idiot250/pixelixx/BOM.csv

Item | Qty | Supplier | Cost/item | Total Cost | link
PCB | 1 | jlcpcb | $4.00 | $4.00 | https://jlcpcb.com
WS2812B | 1 | aliexpress | $9.85 | $9.85 | https://www.aliexpress.com/item/2251832190824742.html?mp=1
Estimated total shipping | 1 |  |  | $3.30
