idiot250/pixelixx/p.kicad_pcb

## KiCad design p.kicad_pcb (2026-11-01)

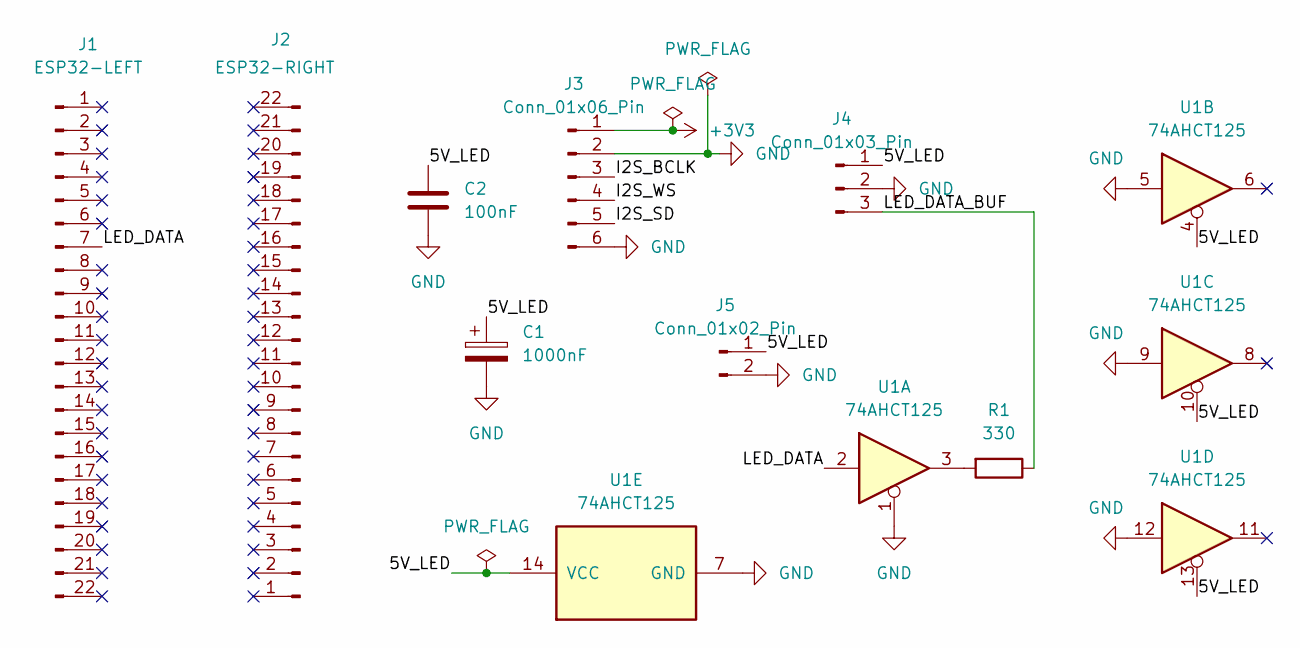
[picture p4: schematic p.kicad_sch]

Parts:
C1: 1000nF; CP_Radial_D10.0mm_P5.00mm
C2: 100nF; C_0805_2012Metric
J1: ESP32-LEFT; PinSocket_1x22_P2.54mm_Vertical
J2: ESP32-RIGHT; PinSocket_1x22_P2.54mm_Vertical
J3: Conn_01x06_Pin; PinSocket_1x06_P2.54mm_Vertical
J4: Conn_01x03_Pin; PinSocket_1x03_P2.54mm_Vertical
J5: Conn_01x02_Pin; TerminalBlock_Phoenix_MKDS-1,5-2_1x02_P5.00mm_Horizontal
R1: 330; R_0805_2012Metric
U1: 74AHCT125; SOIC-14_3.9x8.7mm_P1.27mm

Connections:
+3V3: J3.1
/5V_LED: C1.1, C2.1, J4.1, J5.1, U1.4, U1.10, U1.13, U1.14 (VCC)
/I2S_BCLK: J3.3
/I2S_SD: J3.5
/I2S_WS: J3.4
/LED_DATA: J1.7 (Pin_7_7), U1.2
/LED_DATA_BUF: J4.3, R1.1
GND: C1.2, C2.2, J3.2, J3.6, J4.2, J5.2, U1.1, U1.5, U1.7 (GND), U1.9, U1.12
unnamed: R1.2, U1.3

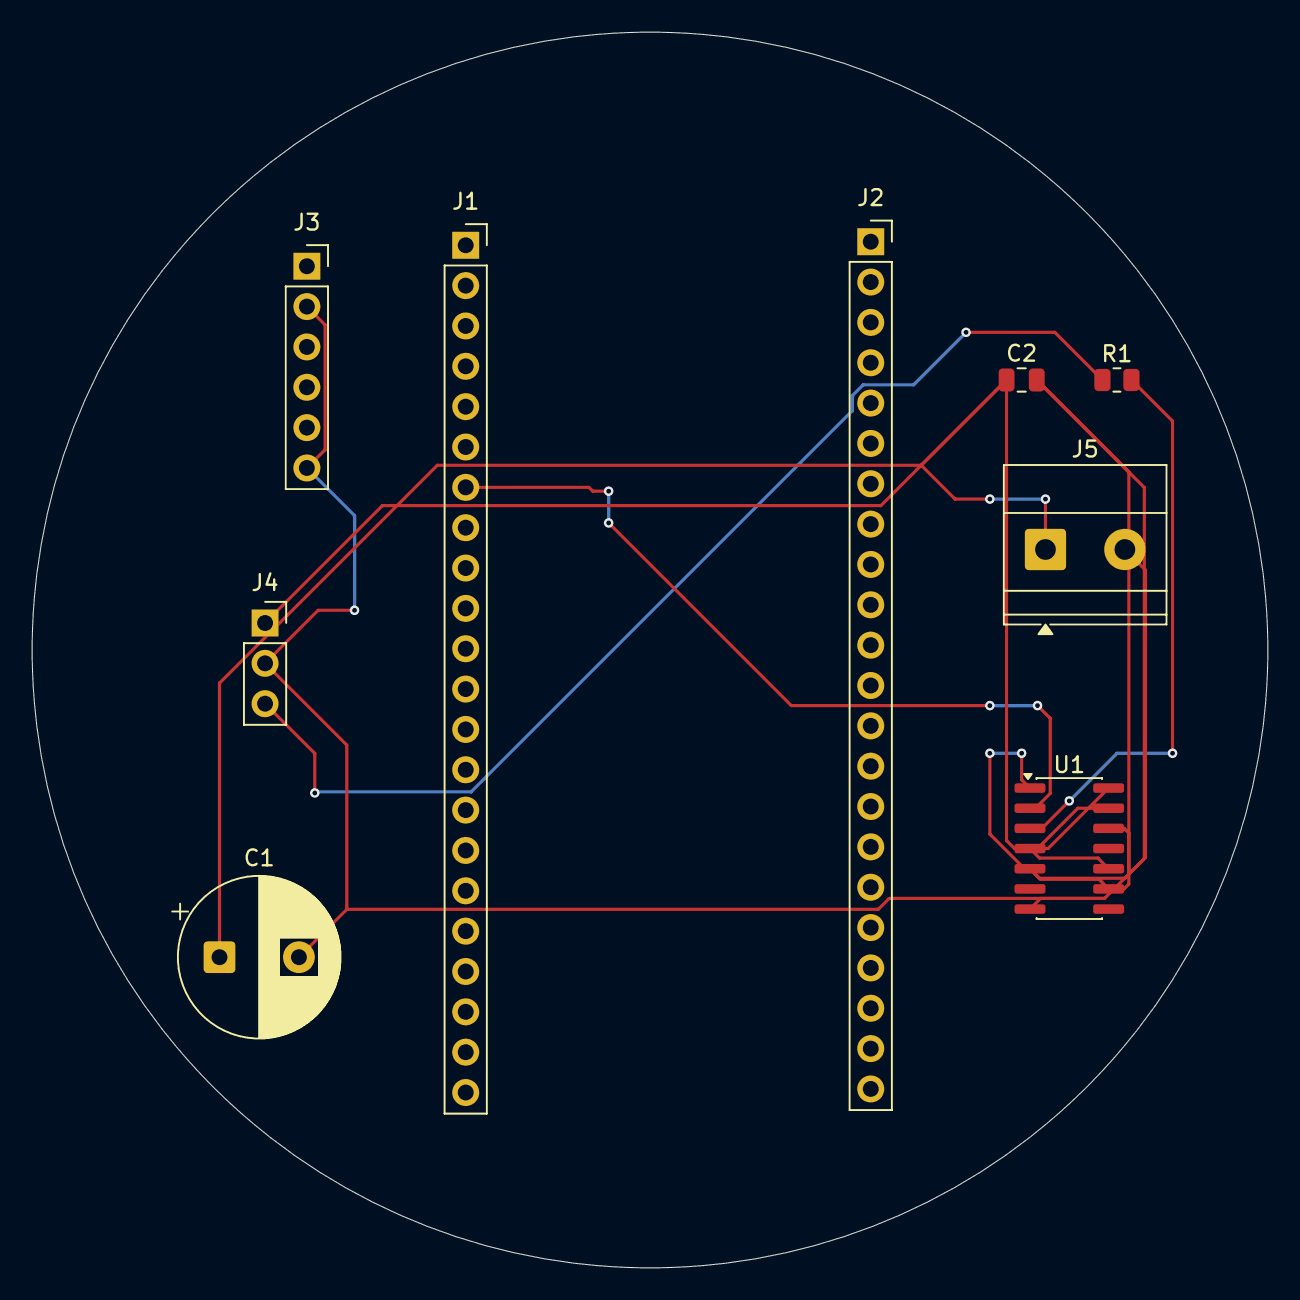
[picture p5: board p.kicad_pcb from above]

Board: 2 copper layers, 77.8 x 77.8 mm, 9 parts (0 on the bottom side), 5 nets.
