idiot250/pixelixx/(commit log)

2026-10-31 Sync pixelp from Half Life
    [BOM.csv]
2026-11-01 finished pcb and gerber output
    [p-B_Cu.gbr, p-B_Mask.gbr, p-B_Silkscreen.gbr, p-Edge_Cuts.gbr, p-F_Cu.gbr, p-F_Mask.gbr, p-F_Silkscreen.gbr, p-job.gbrjob]
2026-11-01 minor fix: pcb
    [p.kicad_pcb, p.kicad_sch]
2026-11-02 Sync pixelixx from Half Life
    [BOM.csv]
